embarquech/nexys2-miner/hardware/case/nexys2_lid.stl

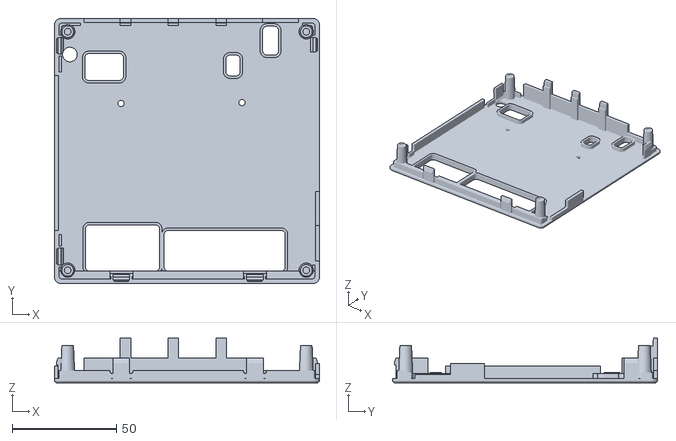
[picture p1: CAD file, 2026-10-26]
hardware/case/nexys2_lid.stl
126.9 x 126.9 x 21.4
