embarquech/nexys2-miner/hardware/case/nexys2_tray.stl

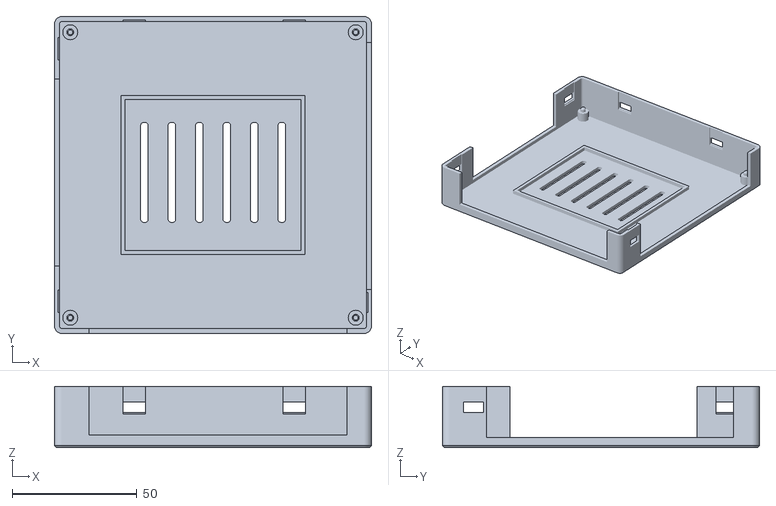
[picture p2: CAD file, 2026-10-26]
hardware/case/nexys2_tray.stl
126.9 x 126.9 x 24.6
