embarquech/nexys2-miner/(commit log)

2026-10-25 Nexys2 SHA-256d miner driven by an ESP32-S3 running ESP-Miner
    Four SHA-256d units on a Spartan-3E XC3S500E at 103.3 MHz, 122 clocks
    per nonce: 3.39 MH/s. The ESP32 precomputes the midstate and rounds
    0-2, sends each job over UART, and re-hashes every hit. Includes the
    VHDL, GHDL testbenches, the command-line ISE flow, the Python USB host,
    JTAG and SVF loaders, the ESP-Miner patch and the shipped bitstream.
2026-10-25 ESP32: pass hits with 24+ zero bits to ESP-Miner (one every ~5 s on the Shares page)
2026-10-25 Share the control logic across units; 76-byte UART job
    The four units run in lockstep, so unit 0 now owns the round counter,
    state machine and nonce counter, and the other three follow it (XST does
    not merge identical registers across units on its own). Synthesis: 7726
    LUTs instead of 8338, 3732 flip-flops instead of 3968.
    With the UART link the job no longer carries the first nonce word and the
    hit mask (both fixed in that build): 76 bytes, magic 0xB8. The ESP32
    driver reads the magic and sends 76 or 84 bytes.
    New shipped bitstream (PAR seed 1): 77.6 MHz worst case instead of 74.4,
    0 wrong hashes in 250 hits at 103.3 MHz.
    [miner_top.vhd, miner_unit.vhd, nexys2.c, sha256_core.vhd, sha256_pkg.vhd, tb_uart.vhd]
2026-10-25 Ship s1 re-clocked to 106.25 MHz: 3.48 MH/s
    Same placement and routing, DCM 17/8 instead of 31/15: 0 wrong hashes in
    900 hits. 106.7 / 107.1 / 107.7 / 108.3 MHz give 0.4 / 0.6 / 1.7 / 2.4 %
    wrong hashes, which cancels the gain. Tighter PAR targets (94 and 98 MHz)
    placed worse (74.3 and 64.8 MHz worst case vs 77.6).
    refreq.sh can now also write the PROM SVF.
2026-10-25 Five units: pass 1's hash in block RAM, 4.10 MH/s
    Pass 1's hash is no longer captured into a 256-bit register: its words
    leave the last four rounds as values of a and e and are written into a
    block RAM, two per clock, midstate added on the way in; pass 2 reads them
    back as message words. That removes the register, six adders and a word
    mux per unit, which makes room for a fifth unit with the two-chain round
    (new CSA generic; the carry-save round with 5 units needs 103 % of slices).
    The two-chain round keeps the chained pass 1 load, so 122 clocks as well.
    Units step through nonces by 8 (register 0x4D); unit 0 drives the control
    for all of them, with the selects in front of adders as per-unit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
    [miner_top.vhd, miner_unit.vhd, nexys2.c, ramb16_sim.vhd, sha256_core.vhd, tb_top.vhd]
2026-10-26 ESP32: expected hash rate with the real unit count, 100 MHz default
    The power task computed the expected hash rate before the driver had
    found the FPGA, so with 4 units; the driver now recomputes it. Frequency
    options 97/100/103/106 MHz (it only sets what AxeOS expects; the clock
    comes from the bitstream), 100 by default as in the shipped bitstream.
2026-10-26 Add the 3D-printable case (tray and lid STL)
    [nexys2_lid.stl, nexys2_tray.stl]
2026-10-26 Case lid: deeper clip catches
    The clip catches now go 0.95 mm into the wall windows instead of 0.55 mm,
    about 70 % more grip, so the lid no longer pops off by itself.
    [nexys2_lid.stl]
2026-10-26 Smaller five-unit build: 112.5 MHz, 4.61 MH/s
    Area, not logic depth, was what held the 5-unit build back (94 % of
    slices). Three cuts, about 350 LUTs:
    - pass 1's hash goes into the block RAM raw; pass 2 reads it into a
    register and adds the midstate word there, one adder per unit instead
    of one per port plus a mux;
    - the ESP32 sends the six per-job sums (h+K3, d+h+K3 of state3, and
    pass 2's round 0 on the IV with midstate words 0 and 1) in a 100-byte
    job, magic 0xB9: six adders less in the FPGA;
    - with the fixed 20-bit mask the hit test is two constant compares on h7
    instead of a 24-bit adder (written as generate blocks: XST 14.7 folded
    the same test written as a function to a co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
    [miner_top.vhd, miner_unit.vhd, nexys2.c, sha256_core.vhd, tb_uart.vhd]
2026-10-26 Ship 114.3 MHz: 4.68 MH/s
    Same placement re-clocked to DCM 16/7: 0 wrong hashes in 2 minutes at
    113.6 and 114.3 MHz (~1 % at 115). ESP32 default frequency 114.
2026-10-26 Six units at 100 MHz: 4.92 MH/s
    The 5-unit design built with 6 units fits at 99 % of slices (91 % of
    LUTs), 69.8 MHz worst case. Re-clocked on the board: 0 wrong hashes at
    100 MHz, ~7 % at 103.3, so 4.92 MH/s against 4.68 for five units at
    114.3 MHz. No VHDL change: NCORES = 6, PAR seed 5, DCM 2/1.
    ESP32 default frequency back to 100.
2026-10-26 Message schedule in block RAM: 6 units at 103.3 MHz, 5.08 MH/s
    At 99 % of slices every LUT freed shows in the silicon. The schedule's
    SRL16 delay line becomes a ring of 11 words in a second block RAM per
    unit: port A writes W(t) and reads back W(t-11) (READ_FIRST), port B
    reads W(t-3) ahead, both registered into W(t-13) and W(t-5), so the RAM's
    clock-to-out stays out of the W adders. The hit capture takes unit 0's
    nonce with the hitting unit's number in the low bits instead of a 32-bit
    mux across units. 8554 -> 8214 LUTs, 13 of 20 block RAMs.
    On the board at 103.3 MHz: ~1 % wrong hashes (the SRL16 version: ~7 %),
    so ~5.03 MH/s useful, 5.08 raw. PAR seed 5, no re-clock. Simulated with
    4, 5 a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
    [miner_top.vhd, sha256_core.vhd]
2026-10-26 Free-running datapath: 6 units at 106.25 MHz, 5.23 MH/s, no errors
    The state and schedule registers now update every clock, loaded or not;
    only the control registers (round counter, running, pass) look at running
    and abort. What the datapath computes while a core is idle is never read.
    XST had already turned the hold into clock enables, so the LUT count barely
    moves (8214 -> 8204), but flip-flops without an enable pack freely into
    slices and the placement came out better: 76.7 MHz worst case (was 72.3),
    and on the board 0 wrong hashes from 103.3 to 106.25 MHz (was ~1 % at
    103.3); the first errors show at 107.1 MHz.
    Shipped at 106.25 MHz (PAR seed 5, DCM 17/8): 0 wrong hashes in 3000
    checked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
    [sha256_core.vhd]
2026-10-26 Revert "Case lid: deeper clip catches"
    The deeper clip catches did not work out; back to the original lid.
    This reverts commit 617573c.
    [nexys2_lid.stl]
2026-10-26 Add REBUILD.md: the exact recipe for the shipped bitstream
    Build arguments, tool options, expected reports, the re-clock to
    106.25 MHz, loading, and the board measurements behind the choice.
2026-10-26 README: bring every section up to the 6-unit build
    Bitaxe ratio, UART speed, PAR seed results for six units, the 1200E
    estimate, the display note, and the experiments that did not work (a
    seventh unit, registered load selects, no adder sharing); History split
    into readable steps.
2026-10-26 PAR at high effort: 6 units at 106.67 MHz, 5.25 MH/s
    Same VHDL and seed as before, with PAR at high effort plus extra effort
    (ise/build.sh takes PAROPT, passed to par as is; the default effort was
    "std" and PAR's own report suggested raising it). 78.5 MHz worst case
    (was 76.7). On the board: 0 wrong hashes in 2000 checked over 10 minutes
    at 106.67 MHz (DCM 32/15); 107.1 MHz was clean for 2 minutes but not for
    10 (5 in 3000), so not kept.
    README and REBUILD.md updated, with the experiments that did not help
    (fewer muxes, the carry-save round with six units, more seeds).
    ESP32 default frequency 107.
2026-10-26 Ship 108.33 MHz (0.37 % wrong hashes) and keep a zero-error 106.67 MHz build
    Same b6x5 placement, two re-clocks, measured over 10 minutes each:
    108.33 MHz (DCM 13/6) gives 0.37 % wrong hashes (11 in 3000) and ~1.2 %
    more valid shares than 106.67 MHz (DCM 32/15), which gives none. The
    default bitstream is now 108.33 MHz; the zero-error one ships as
    bitstreams/nexys2-miner-uart-zero-errors.bit/.svf. REBUILD.md explains
    the two versions and how to make each. ESP32 default frequency 108.
